bristolhackspace/dust-sensor/electronics/layout.pdf

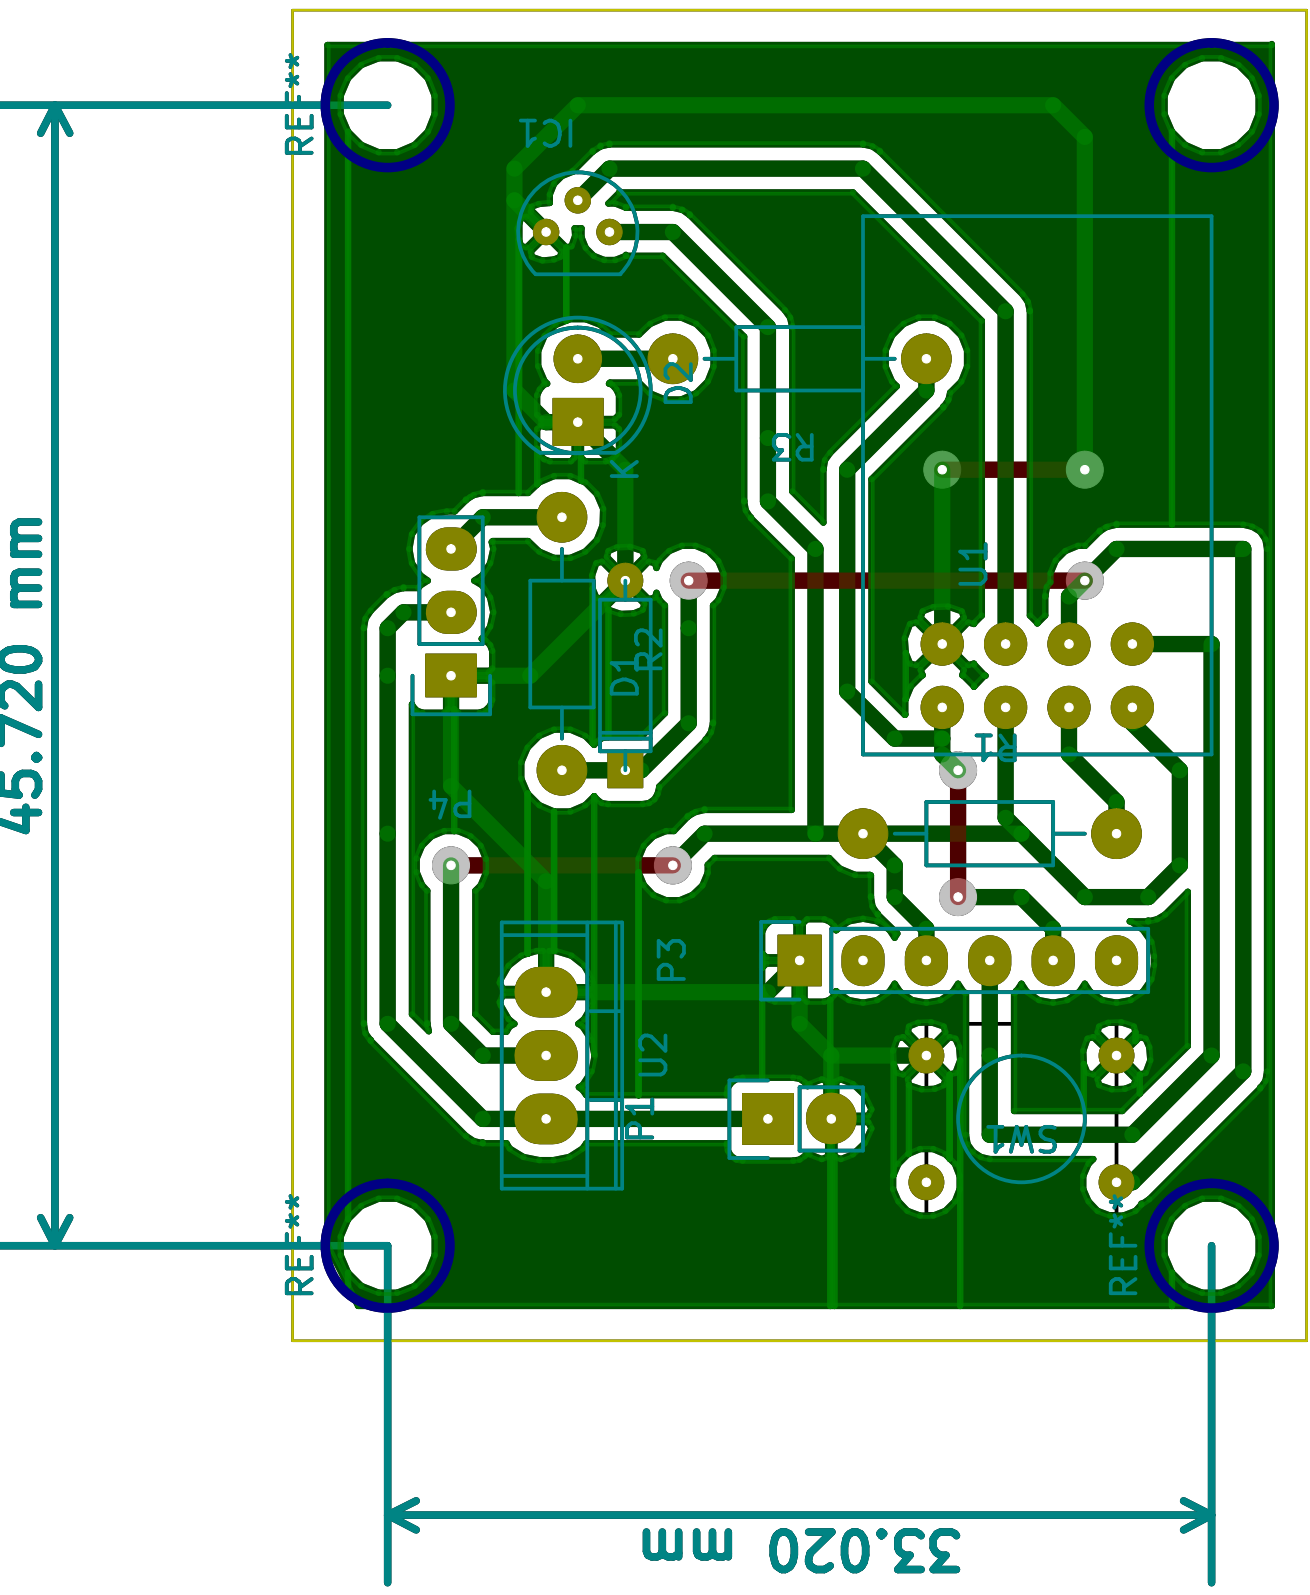
[picture p1: page 1]
