bristolhackspace/dust-sensor/electronics/schematic.pdf

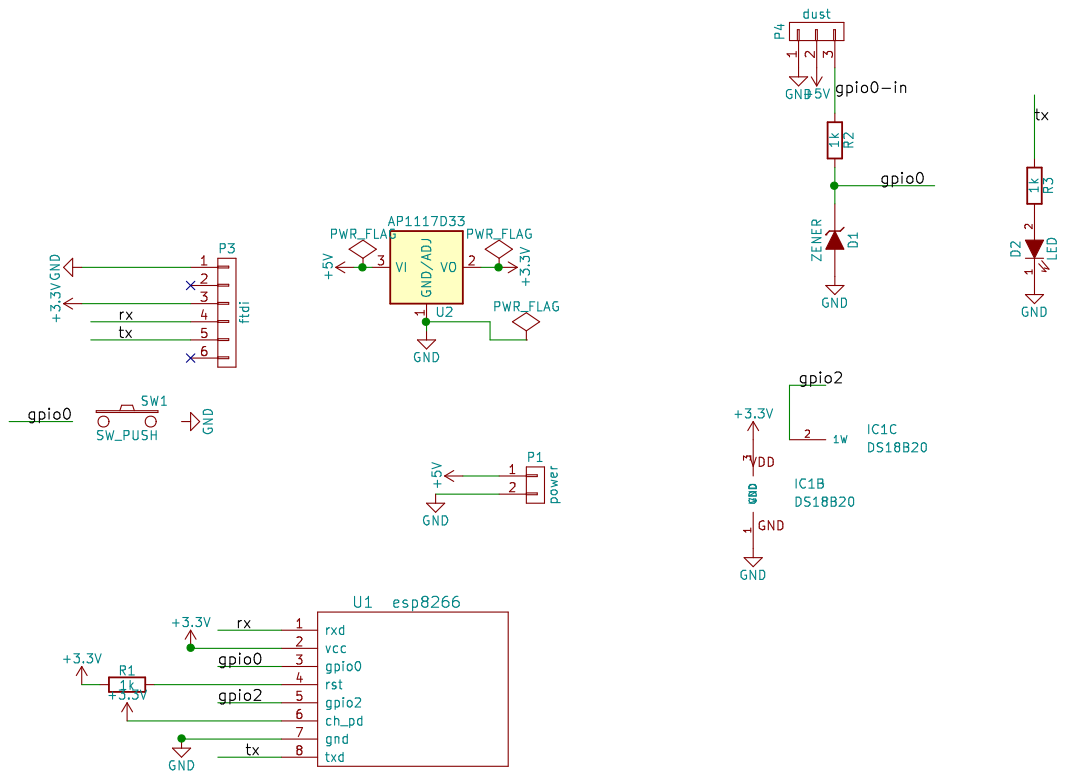
[picture p2: page 1]
