bristolhackspace/dust-sensor/electronics/esp8266 breakout.kicad_pcb

## KiCad design electronics/esp8266 breakout.kicad_pcb (2015-07-14)

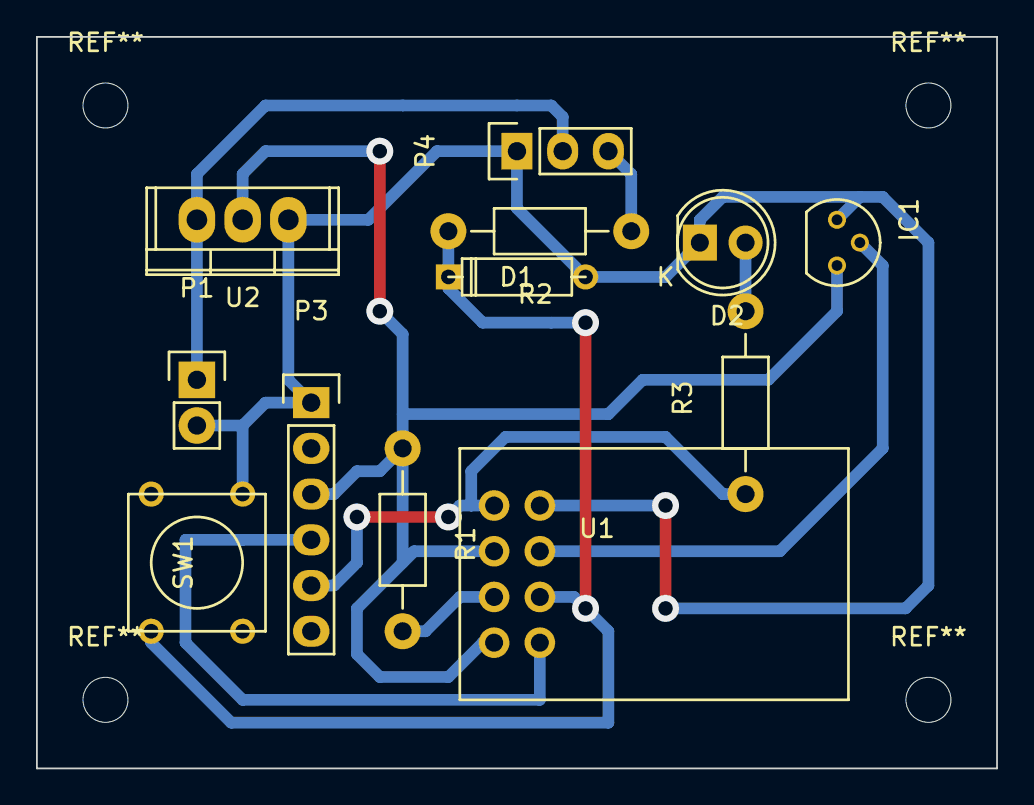
[picture p3: board esp8266 breakout.kicad_pcb from above]

Board: 2 copper layers, 53.3 x 40.6 mm, 12 parts (0 on the bottom side), 10 nets.

Parts:
D1: ZENER; D3
D2: LED; LED-5MM
IC1: DS18B20; TO-92_Molded_Narrow
P1: power; Pin_Header_Straight_1x02
P3: ftdi; Pin_Header_Straight_1x06
P4: dust; Pin_Header_Straight_1x03
R1, R2, R3: 1k; Resistor_Horizontal_RM10mm
SW1: SW_PUSH; SW_PUSH_SMALL
U1: esp8266
U2: AP1117D33; TO-220

Connections:
+3V3: IC1.3, P3.3, R1.1, U1.2, U1.6, U2.2
+5V: P1.1, P4.2, U2.3
/gpio0: D1.1, R2.2, SW1.1, U1.3
/gpio0-in: P4.3, R2.1
/gpio2: IC1.2, U1.5
/rx: P3.4, U1.1
/tx: P3.5, R3.1, U1.8
GND: D1.2, D2.1, IC1.1, P1.2, P3.1, P4.1, SW1.2, U1.7, U2.1
unnamed: D2.2, R3.2
unnamed: R1.2, U1.4
