bristolhackspace/dust-sensor/esp_dust/esp_dust.ino

/*

This is a blend of the sparkfun data demo for the ESP8266 and the grove dust sensor demo.

If we're using an esp12 then we could do the deep sleep in between samples.

 */
#include <ESP8266WiFi.h>
#include "secrets.h"
#define DUST 2
#define TX 1 //led attached
#define MAX_CONC 20000 //this is the highest we'll ever get. Value can be much higher if sensor on its side.

#define SAMPLETIME_MS 1000 * 60 * 1 //sample every 1 mins

// eeprom addresses (storing 2byte ints so each address is +2)
#define EEP_WIFI_CONN 0
#define EEP_REBOOTS 2 

// state machine
#define NOT_CONNECTED 1
#define SAMPLING 2
#define CHECK_WIFI 3
#define POSTING 4

int state = NOT_CONNECTED;

void setup()
{
    Serial.begin(9600);
    Serial.println();
    Serial.println();

    // update number of times rebooted
    setupEEPROM();
    EEPROMWriteInt(EEP_REBOOTS, EEPROMReadInt(EEP_REBOOTS) + 1);

    // pin modes
    pinMode(DUST, INPUT);
}

void loop()
{
    static unsigned long start_time;
    static long lowpulseoccupancy;
    switch(state)
    {
        case NOT_CONNECTED:
        {
            flash_status_led();
            start_wifi();
            EEPROMWriteInt(EEP_WIFI_CONN, EEPROMReadInt(EEP_WIFI_CONN) + 1);
            state = SAMPLING;
            break;
        }
        case SAMPLING:
        {
            if((millis() - start_time) > SAMPLETIME_MS)
                state = CHECK_WIFI;
            else
                lowpulseoccupancy += pulseIn(DUST, HIGH);
            break;
        }
        case CHECK_WIFI:
        {
            if(WiFi.status() != WL_CONNECTED) 
                state = NOT_CONNECTED;
            else
                state = POSTING;
            break;
        }
        case POSTING:
        {
            flash_status_led();
            post(lowpulseoccupancy);
            start_time = millis();
            lowpulseoccupancy = 0;
            state = SAMPLING;
            break;
        }
    }
    delay(10);
}

void post(long lowpulseoccupancy)
{
    float ratio = lowpulseoccupancy/(SAMPLETIME_MS*10.0);  // Integer percentage 0=>100
    float concentration = 1.1*pow(ratio,3)-3.8*pow(ratio,2)+520*ratio+0.62; // using spec sheet curve
    Serial.print("concentration = ");
    Serial.print(concentration);
    Serial.println(" pcs/0.01cf");
    Serial.println("\n");
   
    if(concentration > MAX_CONC)
    {
        Serial.println("bad value, not posting");
        return; 
    }
    
    //send the data to sparkfun
    Serial.print("connecting to ");
    Serial.println(host);
    
    // Use WiFiClient class to create TCP connections
    WiFiClient client;
    const int httpPort = 80;
    if(!client.connect(host, httpPort)) 
    {
        Serial.println("connection failed");
        return;
    }
    
    // We now create a URI for the request
    String url = "/input/";
    url += streamId;
    url += "?private_key=";
    url += privateKey;
    url += "&dust=";
    url += concentration;
    url += "&num_boots=";
    url += EEPROMReadInt(EEP_REBOOTS);
    url += "&num_connects=";
    url += EEPROMReadInt(EEP_WIFI_CONN);
    
    Serial.print("Requesting URL: ");
    Serial.println(url);
    
    // This will send the request to the server
    client.print(String("GET ") + url + " HTTP/1.1\r\n" +
                 "Host: " + host + "\r\n" + 
                 "Connection: close\r\n\r\n");
    delay(10);
    
    // Read all the lines of the reply from server and print them to Serial
    while(client.available())
    {
        String line = client.readStringUntil('\r');
        Serial.print(line);
    }
  
    Serial.println();
    Serial.println("closing connection");
}

void start_wifi()
{
    Serial.print("Connecting to ");
    Serial.println(ssid);

    WiFi.begin(ssid, password);

    while (WiFi.status() != WL_CONNECTED) 
    {
        delay(500);
        Serial.print(".");
    }

    Serial.println("");
    Serial.println("WiFi connected");  
    Serial.println("IP address: ");
    Serial.println(WiFi.localIP());
}
