bristolhackspace/dust-sensor/(commit log)

2015-07-15 working arduino code
2015-07-17 fp libs
    [esp8266 breakout.sch]
2015-07-29 every 1 minute sample
2015-08-08 state machine, use eeprom to store reboots and wifi connects
    [esp_dust.ino, util.ino]
